johngalton/PULSE/Software/Nextion/background.png

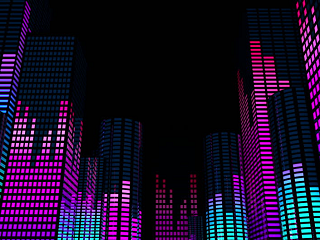
Software/Nextion/background.png
