johngalton/PULSE/Documentation/StripControllerComms.odt

Overview of the RS422 communication

The LED poles are connected to the master controller via a RS422 link. A differential signalling scheme was chosen due to the long cable lengths, and to help reduce the effects of noise. RS422 was chosen rather than RS485 due to the fact each wire is unidirectional. This is needed so the master can send data at any time, and the bus will not be ‘owned’ by a slave device (which can happen when using RS485).

While the master can send data to all poles (via a ‘Y’ split at each pole), a limitation of this scheme is that only one pole can have a return link to the master. This link will go to the last pole in the chain, which should help ensure that the integrity of the entire chain can be determined.

The exact data rate used will be determined in experiments with the full system, however initial tests will aim for 9600 baud. This equates to around 1ms per byte transmitted.

Protocol for the RS422 communication

For the sake of speed there are two types of commands, firstly there needs to be a high speed command to ensure that all LED controllers can get updated as quickly as possible.

[Update][Type][LED1][SIZE1][LED2][SIZE2][LED3][SIZE3][CHECK]

[Update] will have the value 0xFE, however this will be ignored if in between a [Start] and [End]. If this value is detected it will be assumed that the next 7 bytes are for each of the LED strips, each device will be aware of it's own ID value and will only process the correct bytes.

[Type] will have one of the following values:

0x00 Add LED at top of pole (which will then descend at the set speed)

0x01 Set beacon colour (SIZE parameter is ignored)

0x02 Set all LEDs on pole (caution drawing too much current with all LEDs on – maybe limit this to certain colours?)

0x03 Set beacon background colour (SIZE parameter is ignored)

0x04 Flash Target LEDs SIZE > 1 indicates to flash LED. LED indicates the colour

0x05 Add PULSE to the LED's LEDx indicates the colour of it, SIZEx indicates the offset down the pole.

[LEDx] corres ponds to a lookup table of up to 255 24 bit colour codes with value 0 being reserved for no colour, similarly any unrecognised colour code will produce no colour.

[SIZEx] dictates the size of the LED ‘block’ to load, as an integer number of LEDs. A size of 0 corresponds to no block of light; any other number will correspond to between 1 and 255 LEDs.

[CHECK] is a checksum, equal to the XOR of all bytes after [Update]. Whether it is required will be seen in testing. Probably not – you’d need both a glitch in LED and SIZE for anything to start coming down an unwanted pole (0x00 for either means no data).

As any other commands will not need to be processed quite so quickly, these will follow the much more rigid structure dictated below.

[Start][Addr][Cmd][Len][Data(0)]...[Data(Len-1)][End]

[Start] has the value 0xFC.

[Addr] will be the ID of the device you are trying to communicate with – 0x00 will be broadcast.

[Cmd] will be the command you wish the device to execute.

[Len] will be the number of data bytes in this command.

[Data(x)] will be data byte number x.

[End] has the value of 0xFD.

Commands:

Value | Can be broadcast | Description
0x01 | Yes | Set update speed, contains a uint16 specifying the update speed in ms. Note the entire pole delay is equal to update speed * 150. Speed of 0 will turn off the clock.
0x02 | Yes | Get update speed, no data. Get the current update speed of the specified device. Device will return uint16 specifying update speed in ms. Note the entire pole delay is equal to update speed * 150. This can be used as a broadcast command if required, as only one pole has ownership of the return link to the master.
0x03 | Yes | Change beacon fade rate (1 data byte) specifies number of cycles until back to background.
0x04 | Yes | Reset, no data. Will clear all LED's and reset the buffers to empty.
0x05 | Yes | Display pole ID number visually (as a number of blocks). Useful for verifying communication and checking IDs have been set correctly.
0x06 | Yes | Set maximum current. Used to scale back brightness as more LEDs are turned on to avoid excessive voltage drop along strip. Not quite sure what form this will take yet, but determines what point scaling back of brightness happens. Not valid yet.
0x07 | Yes | Reverse direction of scrolling. Useful for graphical effects/other games??? Not valid yet.
0x08 | Yes | Set the direction the LEDs will move in one byte 0 will be down any other value will be up. This will currently also hide the target although I may move this to another command.

Colour Codes:

Byte | Colour (rr.gg.bb) | Colour
0x00 | 0x000000 | Off (black)
0x01 | 0xFF0000 | Red
0x02 | 0xFFFF00 | Yellow
0x03 | 0x00FF00 | Green
0x04 | 0x00FFFF | Cyan
0x05 | 0x0000FF | Blue
0x06 | 0xFF00FF | Magenta
0x07 | 0xFFFFFF | White
