johngalton/PULSE/Documentation/Podium Comms.odt

Podium communication

The podiums communicate with the controller using RS422 over Cat5 cable. The podiums are connected in a daisy-chained fashion, it the ‘data out’ of each connecting to the next’s ‘data in’. A terminating plug is used in the final podium’s ‘data out’ port to enable the return link.

Protocol for the communication

Communication is at 9600 baud, with the usual 8N1 protocol.

Commands

In the below commands, one byte is shown on each line. CR/LF characters are not required.

Command | Response | Function
0xF0 Colour 1 Colour 2 Colour 3 Colour 4 Colour 5 | OK | Sets the colours of each of the five podiums, as well as sets up the addressing. The first connected podium sets its address as 1, then forwards colours 2-5 onwards. The next connected podium sets its address as 2, then forwards colours 3-5 onwards. This continues until the last podium receives its colour, and replies with “OK”. This command must be sent after powerup in order for the buttons to be read – otherwise 0xC0 read commands will return zero for all buttons, and buttons will not broadcast their events. This command also clears test mode if active.
0xC0 | Button data | When 0xC0 (binary 0b11000000) is received, the buttons populate the lowest five bits with their status. This status is true if the button is currently being pressed. The returned format is the single byte 0b110abcde, where a to e represent the five buttons (1 to 5).
0xFB | 0xFB | Activates test mode (off by default). Test mode makes all the LEDs go green when not pressed, and red when pressed. Useful for checking both button and LED wiring/hardware failures
0xFC | 0xFC | Ends test mode. LEDs return to whatever colour they were before test mode was activated.
N/A | Button data | Rather than always requiring polling, the buttons now broadcast their status when an event occurs (pressed or unpressed). The returned format is the single byte 0b110abcde, where a to e represent the five buttons (1 to 5). This will only happen after addresses have been assigned via the 0xF0 command.
