johngalton/PULSE/Documentation/Scoreboard Comms.odt

Scoreboard communication

The hardware method used to communicate to the scoreboard is still to be determined, but it is likely to be RS422 over Cat5 cable.

Currently the only supported method is USB – however as this appears as a virtual serial port, there is no difference from a software point of view.

Protocol for the communication

Communication is at 9600 baud. All commands must be followed by a newline or carriage return character (or both).

Commands

In the below commands, <data> represents an alphanumeric string, and the < and > marks should not be sent.

Format | Function
text=<data> | Prints text to the display. The data field can be any alphanumeric string from 1 to 8 characters, which is immediately printed on the screen. The end of a string longer than 8 characters is ignored. Most characters are printable, and replacements will be automatically made between upper and lower case where required (such as ‘Q’ can’t be drawn on a 7-seg display, but ‘q’ can). Where neither upper case or lower case is possible (such as ‘m’), a dash will be written to the display instead.
numb=<data> | Prints a number to the display. The data field can be any number between 0 and 99,999,999. Decimals and negative numbers are not supported.
score=<data> | Whereas the ‘numb’ command immediately prints a number to the display, the ‘score’ command rapidly counts up to the new number rather than jumping, giving a much better appearance of the score going up. Data should be any number between 0 and 99,999,999. If there isn’t currently a number displayed, it will jump straight to the new one – else it will rapidly count up.
delta=<data> | Similar to score, except takes the increase in score (rather than the new absolute score). Sending this command multiple times will therefore keep increasing the score for each command. Delta only takes positive numbers, and always counts up. If the score was not displayed when the delta command was called, nothing happens.
countTime=<data> | Sets the time (in milliseconds) that the rapid counting happens over when the score or delta commands are called. Defaults to 300ms.
showLeadingZeros=0 showLeadingZeros=1 | Enables or disables the leading zeros for score or number displays (eg 00000100 or 100). Takes effect immediately. Defaults to on.
bright=<data> | Sets the brightness of the display. <data> should be between 0 (off) and 255 (full brightness). Takes effect immediately. Defaults to 200.
clear | Clears the display
pulse | Cuts to black; fades up the word ‘PULSE’, then fades straight back down to black. Takes around 1.5 seconds to complete.
