johngalton/PULSE/Documentation/PULSE game file description.rtf

PULSE ‘.game’ file format

Overview
When a user selects a song to play on PULSE, three files are loaded from local storage. These are:
• The required .game file. This contains full details of the specific game metadata, the name of the required audio track, the song title/artist/difficulty, and the chronological beat/LED data. The full details of this file are described in this document.
• The required audio file. The name of the file is contained in the .game file header, and will be a .MP3 or .WAV file.
• The highscores file for that song. The name of the file is constructed from the song name, difficulty and unique ID contained in the .game file header.
File sections of .game file
The .game file is made up of two sections – a header, and a body. Both sections are designed to be human readable for ease of debugging and modification. It is planned the data will be tab separated to help the human readability of the file.

Header
The header is started by the keyword HEADER. The following parameters are then listed, with one parameter per line, in the format of ‘parameter name’<TAB>’value’<NEWLINE>.
Parameter | Value | Value type
ARTIST | Artist name | String
SONG | Track name | String
AUDIO | Audio file name and extension (eg finalCountdown.mp3) | String
DIFFICULTY | Difficulty of this game file | Integer from 1 to 3 (where 1 is easy, 3 is hard)
DURATION | Song duration in milliseconds | Integer
U_ID | Unique ID for that song and difficulty | Integer

The highscore file used for each song is made up of:
<SONG>&<DIFFICULTY>&<U_ID>.hscore

Body
The body of the file is started by the keyword BODY. The body contains all the information required for the system to play the game. It is listed in chronological order, with each line started by a timestamp in milliseconds. Commands are executed sequentially.
It is important to note that the timestamps given are when the event happens. While this is as you would expect for some events (such as changing podium colours, or changing the speed of the game), it should correspond when blobs (notes) reach the bottom of the poles. This will mean the controller program is required to ‘look ahead’ and transmit blob data to the poles before they are needed, and so they reach the bottom of the pole at the required time.
The body does support comments – and any line starting with a double slash (//) will be treated as such, and ignored.
Each command line is the format below. The number of value fields is defined by each parameter, and is fixed.
‘Timestamp’<TAB>’parameter’<TAB>’value1’<TAB>’value2’<TAB>’value3’…etc…<NEWLINE>
Parameter | Parameter description | Values
PODIUM_LEDS | Set podium button LED colours | Five values, each 1 byte long, each representing the colour of one button (left to right)
BLOB_ADVANCE | Set the delay time for all poles. The delay between each LED should equal this delay divided by the number of LEDs | One value, equal to the total pole delay time in milliseconds. Lower value = faster gameplay
SET_BEACON | Activates a specific beacon to a certain colour | Two values: • Pole number (1, 2 or 3) • Beacon colour (1 byte)
START | Activates the start sequence of lights | No value
SCORE_MODE | Sets the scoring mode (used to increase the value of each blob as difficulty gets harder) | One value, which is the ‘per blob’ multiplier. 0-255
NOTE | The main function used for representing a note. The controller will use this command to activate the required pole’s LEDs (in advance, as discussed above). It will also use this command to know when the button should be pressed | Three values: • Pole number (1, 2 or 3) • Blob colour (0-255) • Blob length (0 = standard, else milliseconds)
STOP | Marks the end of the game

Example file:

HEADER
ARTIST Andy
SONG Not a Real Song
AUDIO randomSeriesOfBeeps.mp3
DIFFICULTY 1
DURATION 13000
U_ID 1
BODY
0 SCORE_MODE 50
0 PODIUM_LEDS 0 2 3 4 0
0 BLOB_ADVANCE 2000
0 SET_BEACON 1 1
0 SET_BEACON 2 1
0 SET_BEACON 3 1
4000 NOTE 1 6 0
4500 NOTE 2 3 0
5000 NOTE 2 2 0
5500 NOTE 3 1 0
8000 BLOB_ADVANCE 1200
// THIS MEANS REALLY FAST MODE NOW!
9000 NOTE 1 6 0
1000 NOTE 2 3 0
1300 STOP
