johngalton/PULSE/Documentation/Pole controller block diagram.pdf

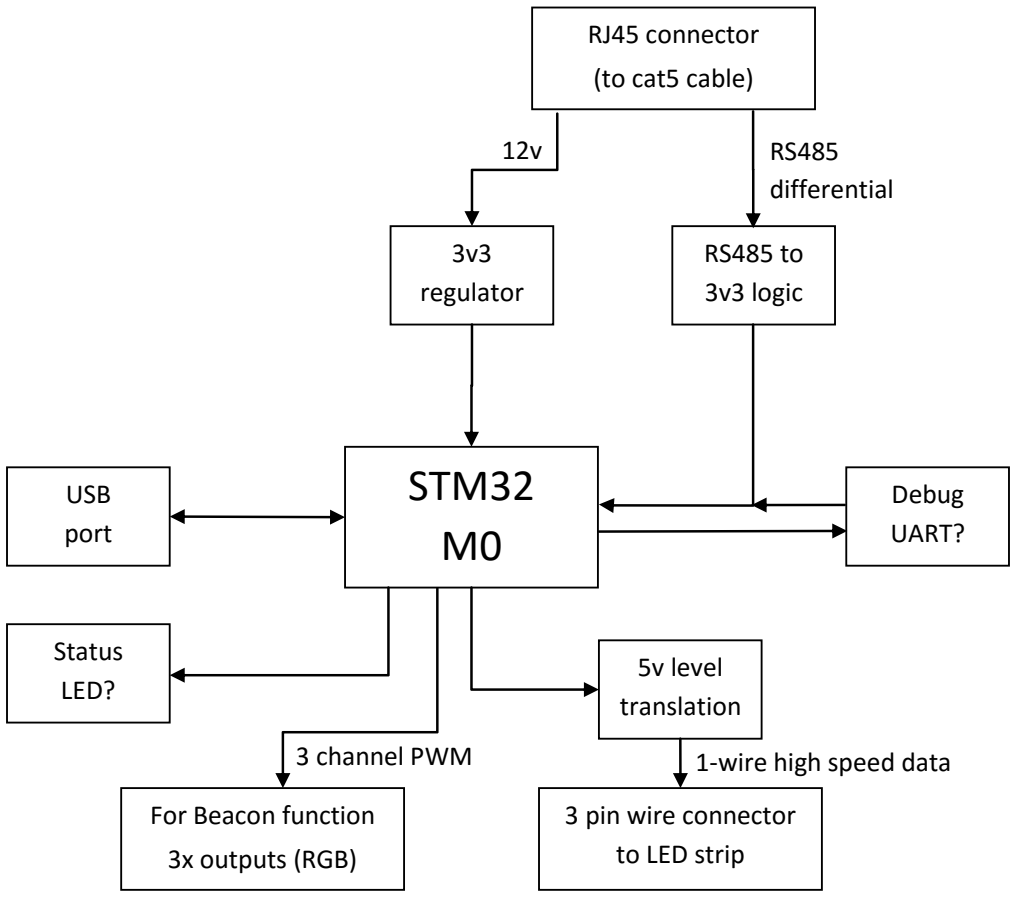
[picture p2: figure]
3 channel PWM; 1-wire high speed data; RS485 differential; RJ45 connector; (to cat5 cable); RS485 to 3v3 logic; STM32 M0; 3v3 regulator; USB port; 3 pin wire connector to LED strip; 5v level translation; Status LED?; For Beacon function; 3x outputs (RGB); Debug UART?
