johngalton/PULSE/Documentation/PILLARS - Device Network.pdf

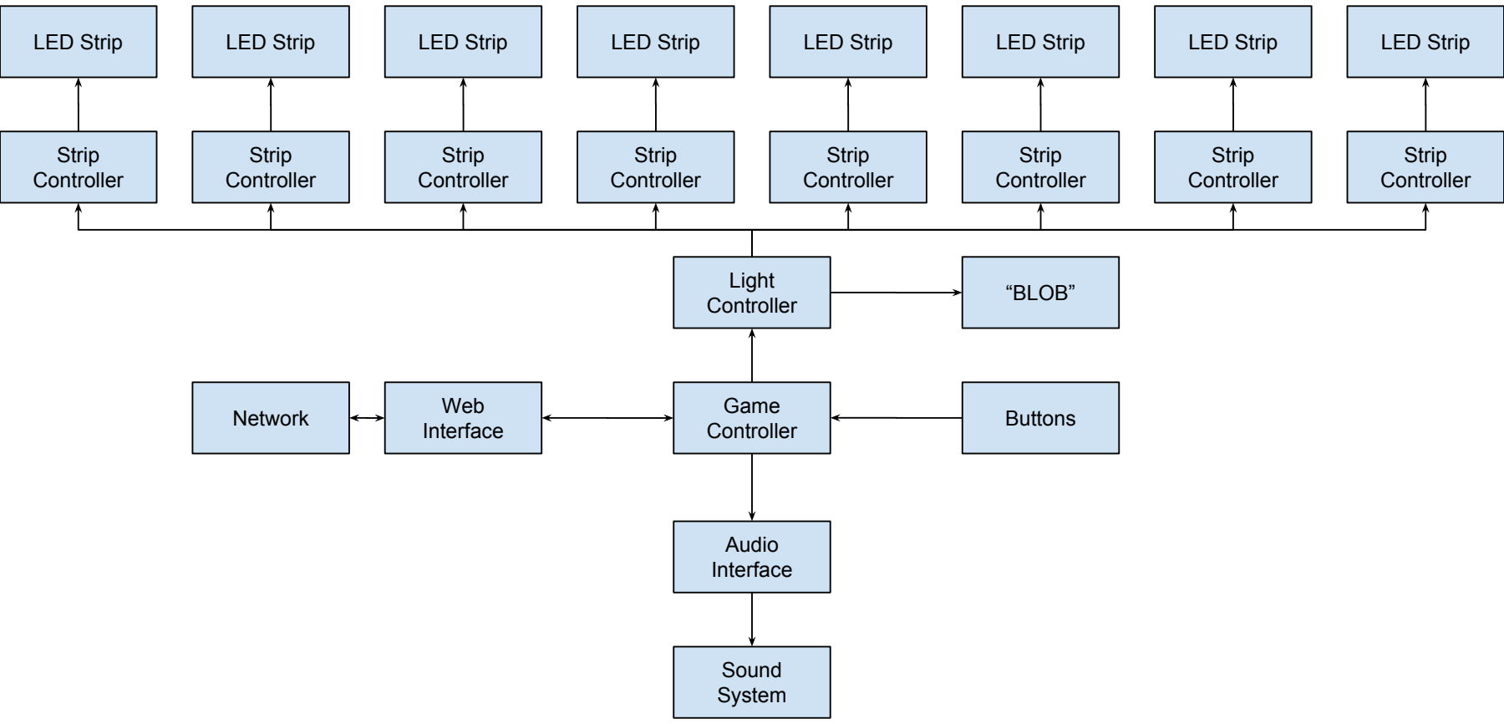
[picture p3: figure]
LED Strip; Strip Controller; Light; Controller; “BLOB”; Game; Buttons Web; Interface; Audio Interface; Network; Sound System
