johngalton/PULSE/Hardware/Pole schematic.pdf

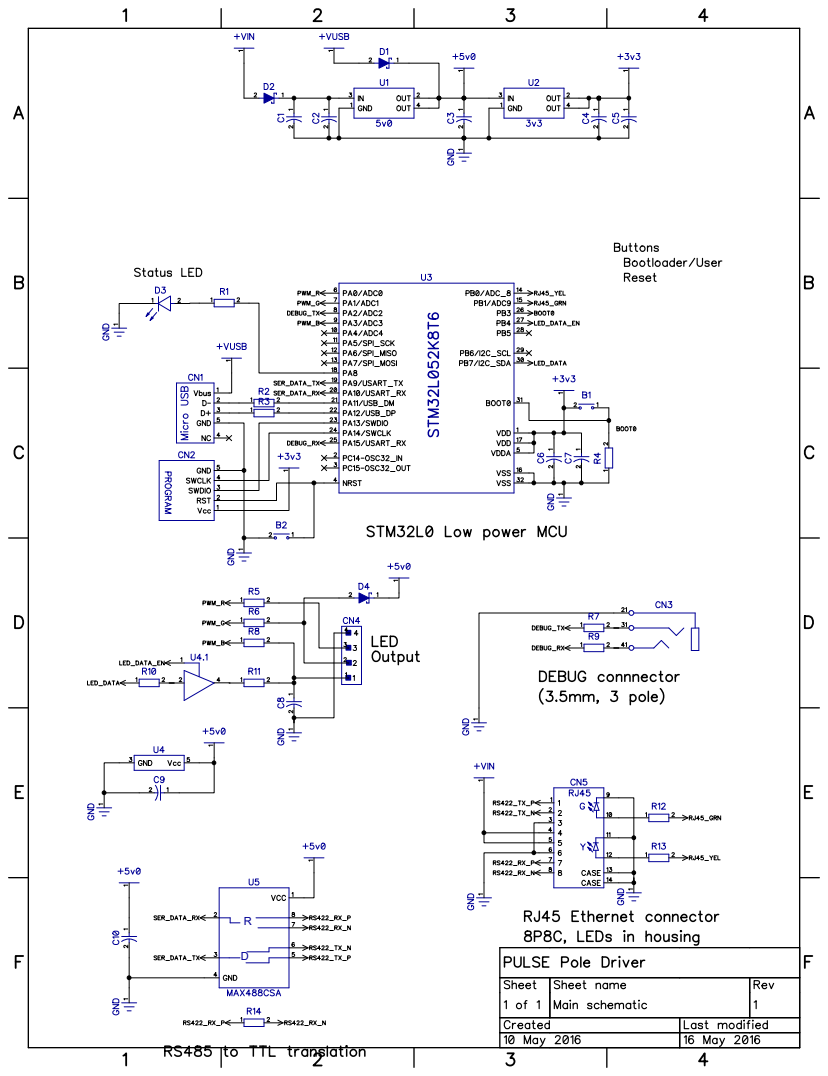
[picture p4: page 1]
