johngalton/PULSE/(commit log)

2016-03-27 Added rough device network diagram.
2016-05-09 Added initial pinout for the L0 processor.
    [pinout.xlsx]
2016-05-10 Generated actual pin out using the cube application. This is to replace the old pinout done in excel.
    [pinout.csv, pinout.xlsx]
2016-05-10 Moved report and pin design to firmware folder. Added pdf report.
2016-05-16 Pole schematic added
2016-05-24 Added basic protocol for the led strip rs485.
2016-06-05 Working LED control with simplified code. Minimal HAL as provided by cube libraries.
2016-06-05 Schematic updated
2016-07-05 Trying to setup timer... Really hate these libraries...
2016-07-05 Wrote the timer code using direct registers since this was easier than the libraries. Note that I have not tested these yet.
2016-07-07 Begun work on the USART setup, just the DMA remaining.
2016-07-09 LED Strip working! UART Commands for strip and beacon.
2016-07-09 Button test code
2016-07-10 Updated code so that it is now timer based.
2016-07-10 Added background colou to the beacon and fixed fade back to that background colour. Also have commands for these and changing the fade rate.
    [led_driver.c, led_driver.h, main.c]
2016-07-10 Fixed Green LED not coming on.
    [main.c, timer.c]
2016-07-10 Made sure that any blank LEDs are not stored in the buffer. This is more in keeping with how the main controller will operate.
2016-07-16 Increased strip size to 200 (needs verifying). Also added some code to verify the uart doesn't eat the processing time. Pretty sure it doesn't anyway.
    [led_driver.c, led_driver.h, main.c, uart.c]
2016-07-16 Added master RS422 driver firmware
2016-07-16 Updated score board comms protocol
2016-07-23 Made the target strip full brightness dim the leds that follow the target significantly.
2016-07-23 Fixed minor issue with target flash. Now doesn't only check red.
    [led_driver.c, led_driver.h, main.c]
2016-07-25 Target now reverts back slower after flash.
    [led_driver.c, uart.c]
2016-07-25 Modified for circular buffer, also added code to only fade the bottom after button pressed.
2016-07-25 Now will disable timer if interval set to 0.
2016-07-26 Fixed bug where led_update didn't account for circular buffer.
    [led_driver.c]
2016-07-26 Another bug in the circular buffer, this time in propagate.
    [led_driver.c]
2016-07-26 Massively shortened the led_update sequence
    [led_driver.c]
2016-08-03 Synchronisation fixes for the buttons
2016-08-03 Now set PB4 high (enable pin).
2016-08-05 Beginning rewrite of button detection code
2016-08-05 Now have to release the buttons before pressing a new one.
2016-08-05 Hopefully working with all the buttons.
2016-08-05 lower case in false..
2016-08-06 Added separate multiplier streak so that we can note lose the note streak when a wrong button is pressed.
2016-08-06 Changed scoreboard to use autonomous fading, to eliminate buffer overflow bug seen previously
    [Pulse_Scoreboard.ino]
2016-08-06 Changes to the LED drivers.W
2016-08-07 Exit button window on button press
2016-10-07 Rewrote receive code to use a timeout, rather than waiting for a packet to complete. Also added podium test mode for easy checking of button failures. Documentation modified to reflect changes
    [Pulse_podium_slave.ino]
2016-10-10 Initial attempt at inverting pole direction.
    [led_driver.c, led_driver.h, main.c]
2016-10-10 Fixed bug in scoreboard
    [Pulse_Scoreboard.ino]
2016-10-10 Working with reverse direction.
    [led_driver.c]
2016-10-10 Sped up the reversed direction.
    [led_driver.c]
2018-01-22 Initial commit of PULSE V2 files (redesign in C++)
    [Pulse_II.ino, VS1053.cpp, VS1053.h, audioLib.cpp, audioLib.h, calendar.cpp, calendar.h, errorCodes.h]
2018-01-25 Moved files into Pulse_II folder (for arduino compatibility)
2018-01-25 Added support for endFillByte, to ensure audio codec finishes gracefully at the end of a song. Fixes the issue where ogg files coundn't be synchronised after a track was played once
    [VS1053.cpp, VS1053.h]
2018-01-25 Added support for the countdown track at the start of a song. Must be on SD card in /Intro/321.ogg
2018-01-26 Updated podium controller to use event based serial comms, rather than polled comms. Each podium stores the status of the others further up the chain, so can announce the complete current state.
2018-01-26 Added Pole class, to communicate with the firmware in the LED strip controllers. Code compiles, but currently untested (awaiting hardware build)
2018-02-02 Added functionality to search calendar class to determine if there is a valid note at a certain moment in time (ie when a button is pressed). Supports flexible window sizes, for accepting button pres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
2018-03-11 Converted the audio codec to communicate with an external I2C DAC, instead of using the inbuilt one. Tested working, significantly better audio quality!
2018-04-27 Auto retry on SD card initialization failure
    [audioLib.cpp]
2018-04-27 Found a new bug on the second hardware build - the audio codec fires during initialization, and never returns from the interrupt. Easy fix to check the codec has been initialized before processing th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
    [VS1053.cpp]
2018-05-26 Added 'addNoteBlock' method, to allow automatically assigning the note colour. Supports multiple simultaneous poles/colours. Fixed a few errors and tested working
    [pole.cpp]
2018-05-26 Modified pinout to keep in line with new hardware build (no longer using a shield)
    [VS1053.h]
2018-05-26 Working changes; LED strip now controlled correctly
    [Pulse_II.ino]
2018-05-26 Reversed colour order to match note class. Turns out update speed only updates if it is two bytes.
    [pole.cpp]
2018-10-28 Added ability for the number of notes in a track to be stored in the track data after a successful parse
2018-10-28 Added ability to decode track length from ini file (required for progress bar on GUI)
2018-10-28 Now also print the song length when printing the songbook to the terminal
2018-12-08 Added code to support 5 LED lights on the front panel
